fbelavenuto/msxsdmapper/Hardware/JTAG-SDMapper.png

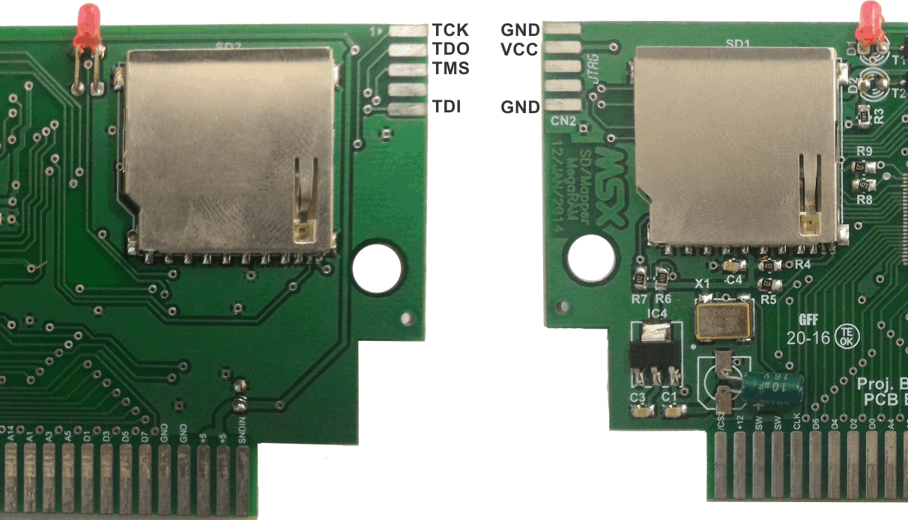
Hardware/JTAG-SDMapper.png
