fbelavenuto/msxsdmapper/Hardware/Etiqueta/SD-Mapper-Label_patola_x1.pdf

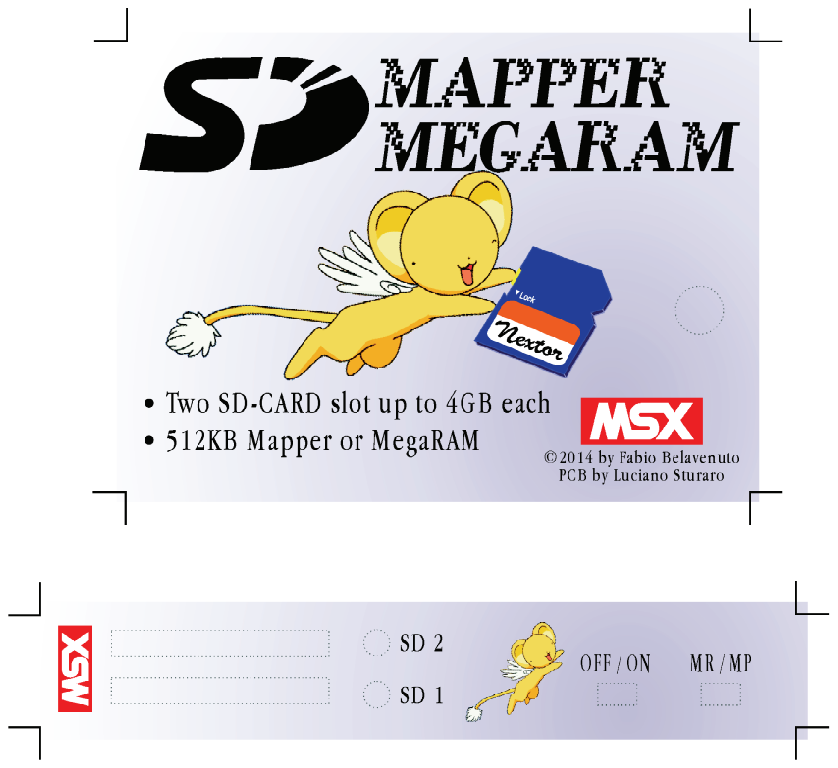
[picture p2: page 1]
