fbelavenuto/msxsdmapper/Hardware/PCAD/SD-Mapper-view.pdf

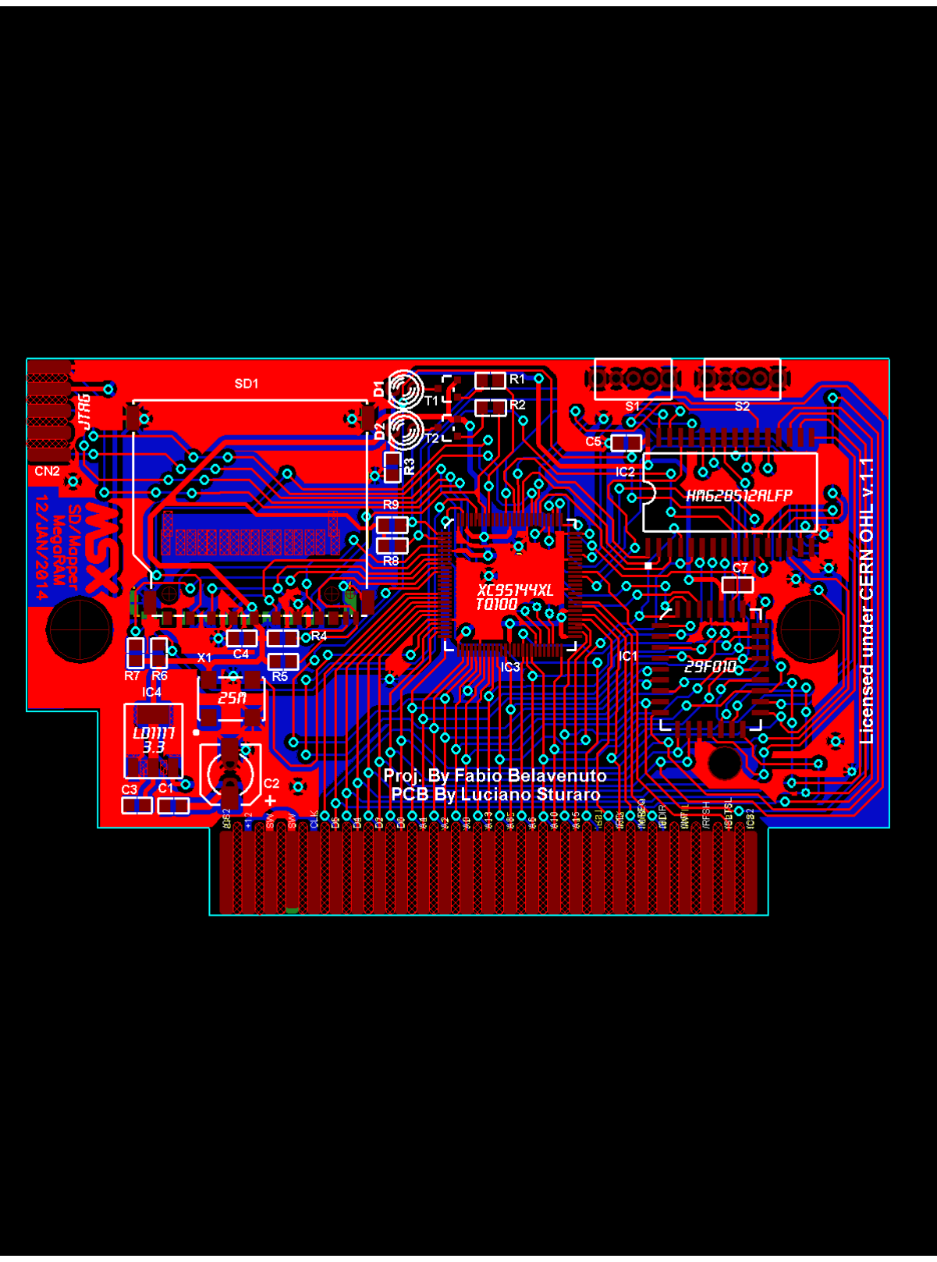
[picture p3: page 1]
