fbelavenuto/msxsdmapper/(threads)

Thread 1 (2019-09-23):

Possible problem with ver 1.0.6

jgilcas, 2019-09-23:
Hi.

I think there is a problem in version 1.0.6.
When writing to the SD card the file system is corrupted.
I have tried with previous version (1.0.4) and is working ok.

Thank you.

rapiqui, 2019-09-27:
Hi.
I can confirm that I am experiencing the same issues exposed by @jgilcas.
Using the 1.06 version I get eventual data corruption on the SD, becoming this non usable.

I've tried several SD brands and sizes, and altough it's somehow a random pattern, they do get corrupted after some SDMapper usage.

Thanks!

Emily82, 2019-11-26:
I confirm too. Just flashed new beta 2 kernel version and as i write to SD filesystem is corrupted.

Emily82, 2019-11-27:
I tried latest alpha2 version built SDMAPPER.ROM from older commits in Belavenuto's github page (commit 9cca901cadc1501308d6b337f174472c8b41a7b6)

Flashed it and i discovered that it still corrupts the filesystem!

It seems that bug occurred not with Nextor beta2 support but before!

Emily82, 2019-12-24:
I found a possible problem related to this issue.

In `driver.asm` variable `CODE_ADD` value is `0F84Ch` but in Nextor version beta 2 this variable has changed.

Its new value is `F1D0h`. (Breaking Change)
Check here https://github.com/Konamiman/Nextor/releases

FabianoAmerico, 2023-11-08:
Hello, Fabio.
Same problem here. SD Card gets corrupted after write anything on it after the update. Any tip to fix it?
Enfrentando o mesmo problema aqui. SD card corrompido ao gravar algo nele após a atualização. Alguma dica para reparar?

Emily82, 2023-11-09:
And 1.04 version was removed from tags, considering its the only stable working version

FabianoAmerico, 2023-11-09:
> And 1.04 version was removed from tags, considering its the only stable working version

I found a way to return to version 1.0.4 and fix everything!
Using the SDMAPPER_patch_ciel2+.ROM file (https://github.com/fbelavenuto/msxsdmapper/tree/master/Driver) to rewrite the EPROM.
Now everything is back to normal, that is, no more corrupted SD cards!

Eu consegui uma maneira de retornar para a versão 1.0.4 e consertar tudo!
Utilizando o arquivo SDMAPPER_patch_ciel2+.ROM (https://github.com/fbelavenuto/msxsdmapper/tree/master/Driver) para reescrever a EPROM.
Agora tudo voltou ao normal, ou seja, sem cartões SD corrompidos!

fbelavenuto, 2023-11-10:
Hi Guys, please test this ROM:

https://github.com/fbelavenuto/msxsdmapper/blob/fixdriver/driver/SDMAPPER.ROM

FabianoAmerico, 2023-11-11:
> Hi Guys, please test this ROM:
>
> https://github.com/fbelavenuto/msxsdmapper/blob/fixdriver/driver/SDMAPPER.ROM

Nope... Lost everything on the SD Card again even with this new version.

fbelavenuto, 2023-12-03:
Bug fixed, please test with latest release (SDMAPPER.ROM was updated)

Emily82, 2023-12-03:
I just tested the latest sdmapper.rom with the latest smupd.com, flashed it but the problem isnt fixed. I created a text file with ted.com and it gets corrupted, it was renamed with garbage characters.

Now i flashed it back to old 1.04 and it works well.

fbelavenuto, 2023-12-05:
Fixed, get the latest version on release page (1.0.7)

Emily82, 2023-12-06:
Yea it works now! I tested it and it seems also faster copying files from my gotek to sd. Before with 1.04 version it was very slow.

Closed 2023-12-05.

Thread 2 (2022-01-07):

3D cartridge case?

mrgw454, 2022-01-07:
Hello there.  While not an issue, I am a happy owner/user of your Mapper cart (v1) and wondered if you had STL files available for a 3D printed case?  Thanks for any information you can provide!

fbelavenuto, 2022-01-10:
Hi, unfortunately I don't have the STL files for the case!

fbelavenuto, 2024-02-15:
Hi, I found this project (made by another person, not me):

https://www.printables.com/en/model/496236-msx-cartridge-for-fblabs-sd-mapper-v2

mrgw454, 2024-02-15:
> Hi, I found this project (made by another person, not me):
>
> https://www.printables.com/en/model/496236-msx-cartridge-for-fblabs-sd-mapper-v2

Very helpful -- thank you for letting me know about this!

-Ron

Thread 8 (2024-01-27):

Driver not found

PicoElements, 2024-01-27:
Hello!
Trying on a Toshuba XH-20 , with both switches on the right, i get "driver not found" message and system halted, with or without SD card.

Can you help ?

Thanks a lot,
Stefano

fbelavenuto, 2024-02-05:
Hello, this problem happens because this MSX has built-in software. The only solution I know is to disable this software by modifying the MSX motherboard.

Thread 9 (2024-05-13):

Problem UPDATING 1.04 rom to 1.07 latest

fmvillares, 2024-05-13:
HI there i have the sd mapper and works fine but i want to update 1.07 rom and  executing smupd.com  with the sdmapper.rom returns that no mapper is detected....
both switches are turned on mapper works fine sd is fine nextor is updated ...
what could i been doing wrong?
Best regards

Thread 10 (2024-09-05):

Is it safe to update an older 8bits4ever SD-512 to 1.0.7?

mfeingol, 2024-09-05:
I have an 8bits4ever SD-512 from 2016. It's the older model with one switch to enable/disable the memory mapper. It comes with version 1.0.4 and an older Nextor.

Is it safe to update this unit to version 1.0.7? 8bits4ever told me there was a possibility that it could brick the unit.

Thanks.

fbelavenuto, 2024-09-23:
Hi, yes, it's safe.

mfeingol, 2024-09-23:
Thanks. Should `SDMUPD.com` be run from the SD card itself, or from a floppy disk?

fbelavenuto, 2024-09-23:
> Thanks. Should `SDMUPD.com` be run from the SD card itself, or from a floppy disk?

Another device. Uses a floppy or another mass storage device.

mfeingol, 2024-09-23:
I wonder if people reporting bricked devices are running the update from the same device, and that's what's leading to problems?

fbelavenuto, 2024-09-23:
> I wonder if people reporting bricked devices are running the update from the same device, and that's what's leading to problems?

Yes, that's what causes problems. If the MSX boots with the interface bricked, you can still try to reburn the firmware.

mfeingol, 2024-09-23:
Flashed successfully, thank you. A scary moment when after erasing the mapper for the first time, the MSX rebooted. Running the update again did the trick. Good thing I had MSX-DOS on the floppy. :-)

Closed 2024-10-23.
