fbelavenuto/msxsdmapper/Hardware/Etiqueta/v2/msx mapper.pdf

# MAPPER

# MEGARAM

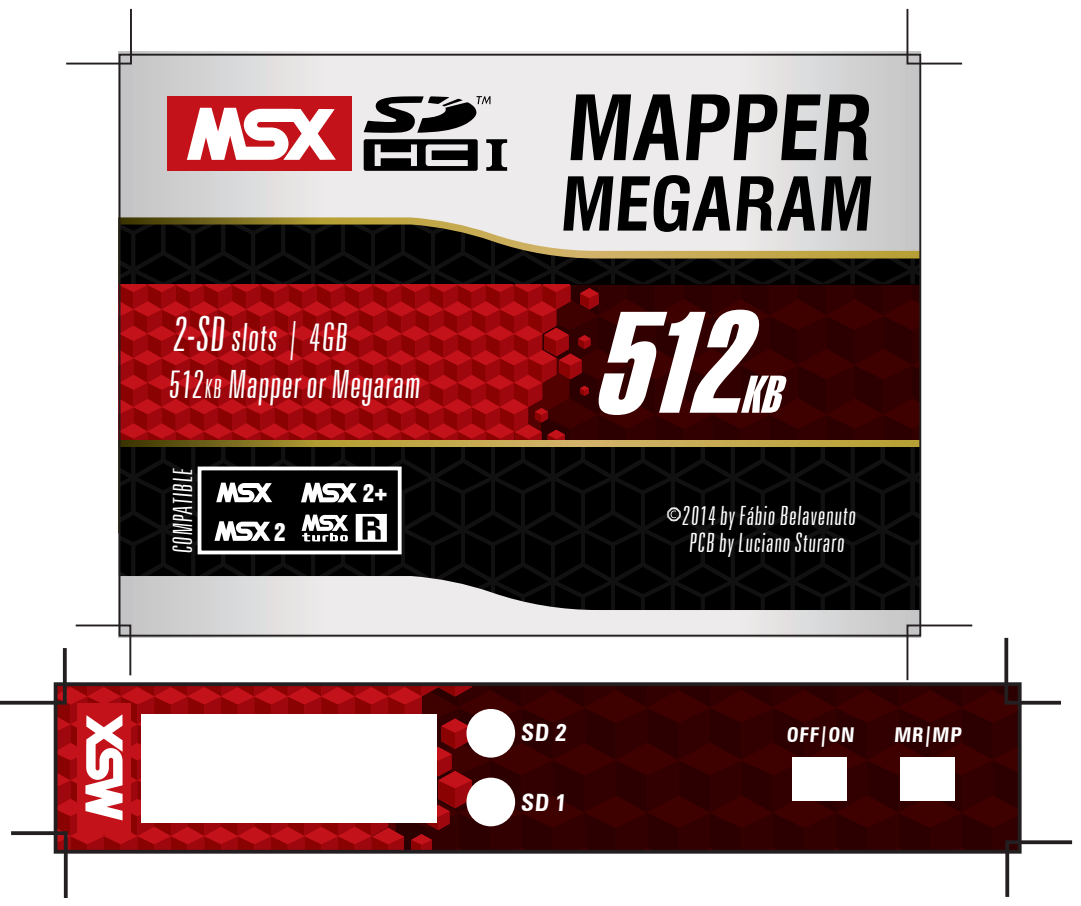
[picture p4: page 1]
OFF|ON; 2-SD slots | 4GB; 512KB Mapper or Megaram; 512KB COMPATIBLE

2014 by Fábio Belavenuto
PCB by Luciano Sturaro
