fbelavenuto/msxsdmapper/Hardware/esquema.pdf

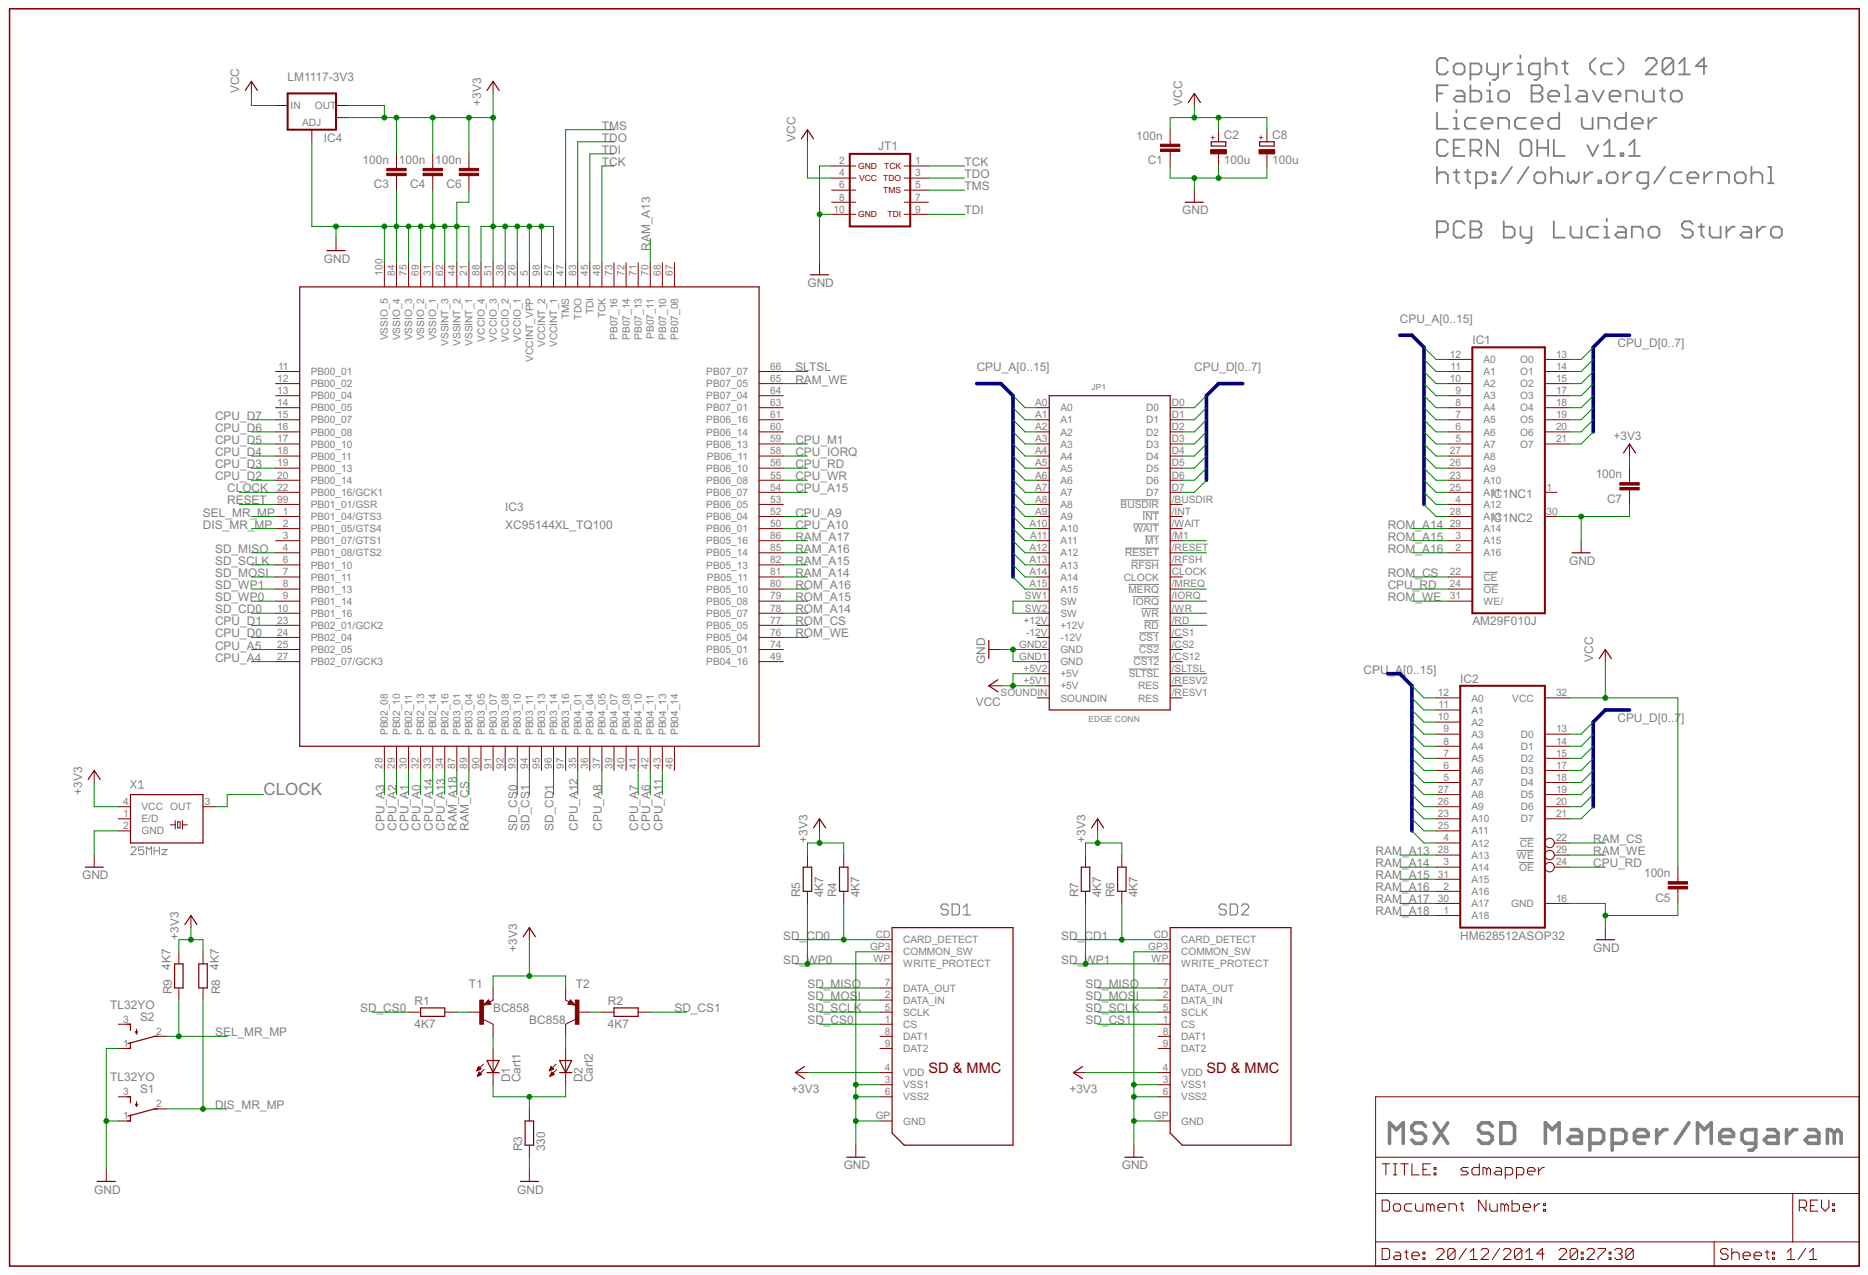
[picture p5: page 1]
