fbelavenuto/msxsdmapper/Hardware/PCAD/pdf/SD-MAPPER-FINAL_VERSION-[BOTTOM].pdf

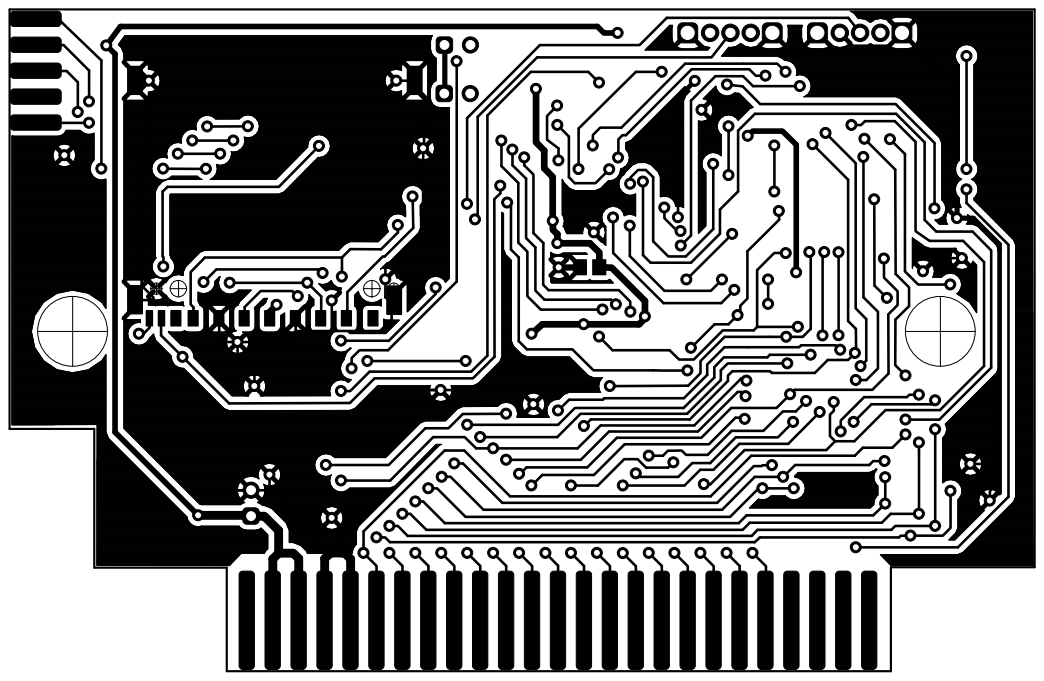
[picture p6: page 1]
