fbelavenuto/msxsdmapper/Hardware/PCAD/pdf/SD-MAPPER-FINAL_VERSION-[SILK_BOTTOM].pdf

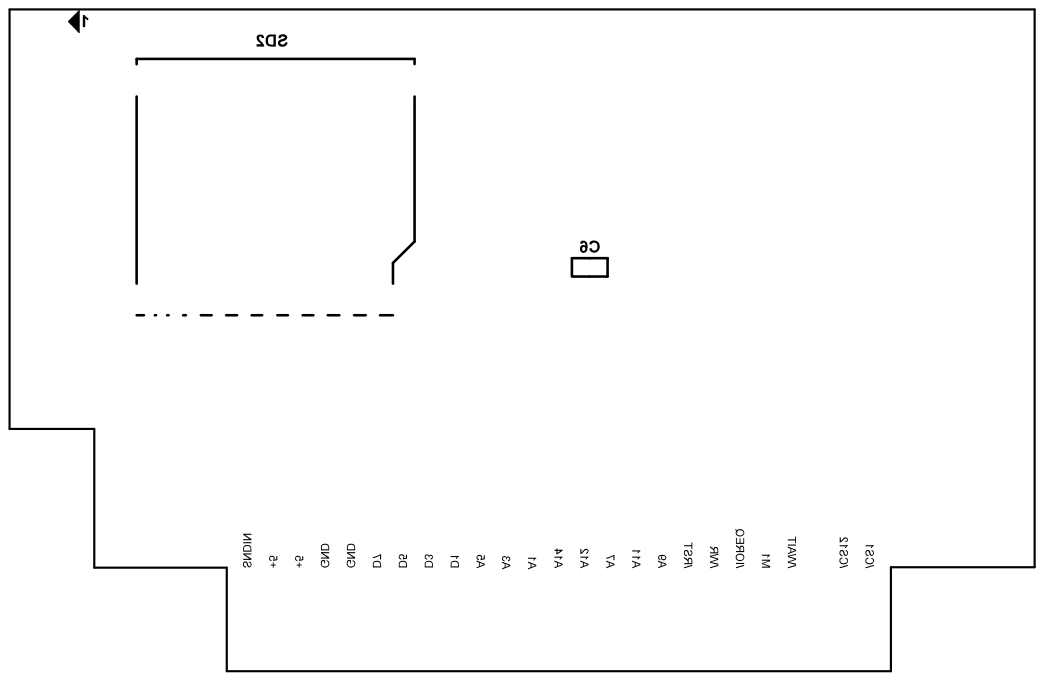
[picture p7: page 1]
