fbelavenuto/msxsdmapper/Hardware/PCAD/pdf/SD-MAPPER-FINAL_VERSION-[SILK_TOP].pdf

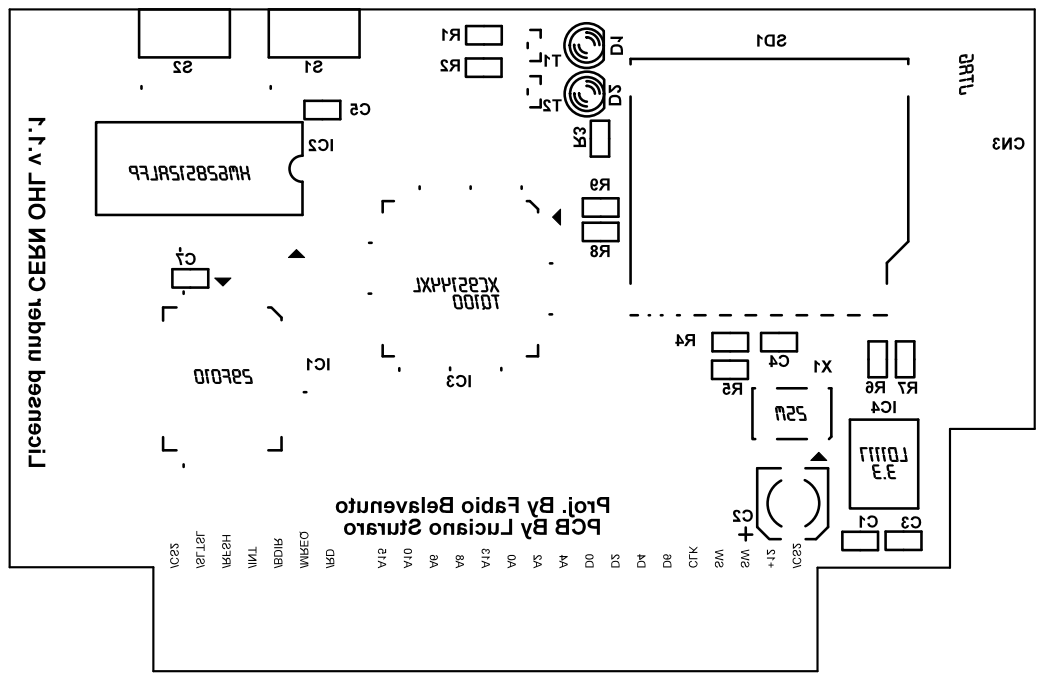
[picture p8: page 1]
