fbelavenuto/msxsdmapper/Hardware/PCAD/pdf/SD-MAPPER-FINAL_VERSION-[TOP].pdf

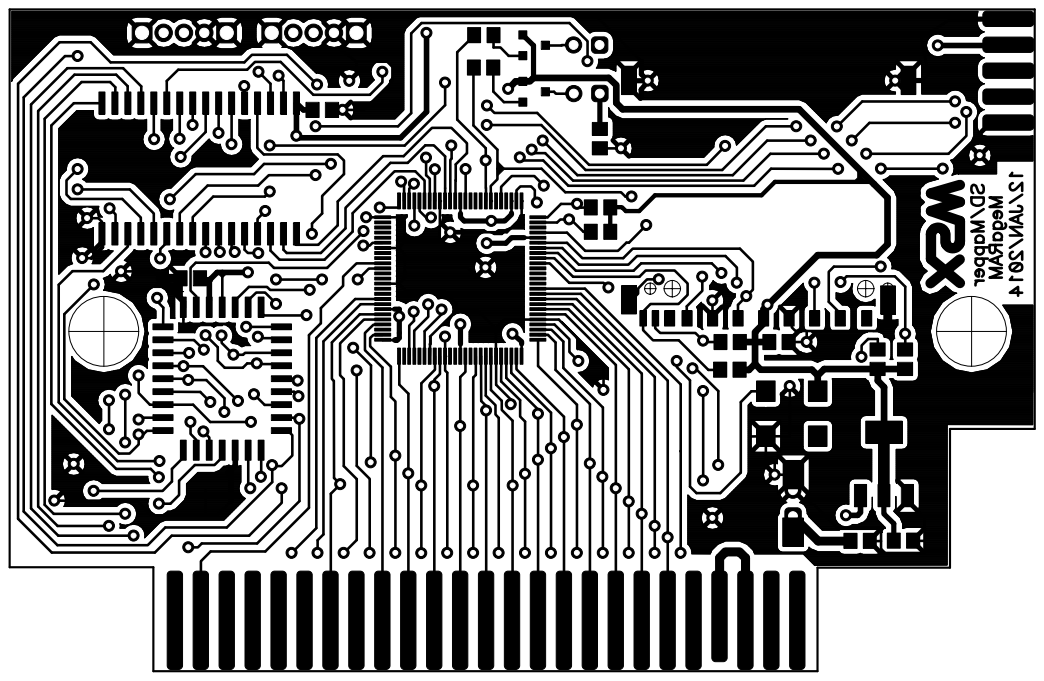
[picture p9: page 1]
