fbelavenuto/msxsdmapper/(commit log)

2014-01-10 upload inicial
    [sdmapper.brd, sdmapper.sch]
2014-01-10 Updater: adicionado reconhecimento de mais chips flash
2014-01-10 Terminado layout da placa Atualizado esquema.pdf Atualizado pinout no projeto do ISE
    [sdmapper.brd, sdmapper.sch]
2014-01-10 Corrigido footprint da SRAM Retirado LEDs comuns e trocado por LED bi-color Layout da placa foi otimizada
    [sdmapper.brd, sdmapper.sch]
2014-01-11 Otimização na placa utilitário de gravação reconhece mais marcas/modelos de flash adicionado binários do driver e atualizador
    [sdmapper.brd]
2014-07-31 Modificado porta SPI no CPLD para trabalhar assincronicamente. Adicionado oscilador de 25MHz na placa. Modificado porta de controle do updater. Estudando desenvolvimento do driver para Symbos
    [sdmapper.brd, sdmapper.sch]
2014-09-12 CPLD com pinout do produto final. Adicionado versao 2.0.3 do Nextor. Mudado nome da ROM de NEXTOR.ROM para SDMAPPER.ROM Adicionado na inicializacao do driver a chamada a funcao INITXT para exibir men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
    [sdmapper.brd, sdmapper.sch]
2014-09-12 Adicionado Driver.lst Retirado arquivos temporarios do CPLD
2014-10-16 Adicionado gerbers da placa roteada pelo Sturaro Adicionado versão em PDF e postscript da placa para fabricação caseira Adicionado lista de materiais Adicionado etiquetas em alta resolução para a cai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
    [sdmapper.brd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]
2014-11-04 Atualizado versão no Nextor para 2.0.4 Realocado alguns diretórios para acomodar versões diferentes do Nextor
2014-12-20 Adicionado arquivos de gravação do CPLD nos formatos STAPL e SVF. Adicionado versão do driver em binário com patch para funcionar nas máquinas CIEL 2+. Corrigido BUG na placa onde o pino 1 da flash f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
    [sdmapper.sch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]
2015-03-18 Atualizado versao do Nextor para 2.1 alpha 2
2016-10-19 Corrigido bug na captura das portas da Mapper, agora interface funciona nos micros Expert Plus e DD Plus
    [exp_slot.vhd, megamapper.vhd, sdmapper.vhd]
2017-05-24 New driver with FRS enhancements.
2017-05-24 Driver enhancements, version 1.0.6
2017-11-11 Bugged driver (replaced with 1.0.4 version)
2023-11-09 Try fixing driver with @Emily82 discover
2023-12-11 Organizing documentation and files. Using Docker to compile the CPLD bitstream Testing Github Actions
    [SD-MAPPER-FINAL_VERSION.GBL, SD-MAPPER-FINAL_VERSION.GBO, SD-MAPPER-FINAL_VERSION.GBS, SD-MAPPER-FINAL_VERSION.GKO, SD-MAPPER-FINAL_VERSION.GTL, SD-MAPPER-FINAL_VERSION.GTO, SD-MAPPER-FINAL_VERSION.GTS]
